AMDHome/Mechanical-Speedometer-Converter/assets/Schematics/OrCad/Symbol/Arduino Schmatic/Link.txt

https://www.snapeda.com/parts/A000005/Arduino/view-part/
