AMDHome/Mechanical-Speedometer-Converter/assets/High Level Diagram/Diagram.png

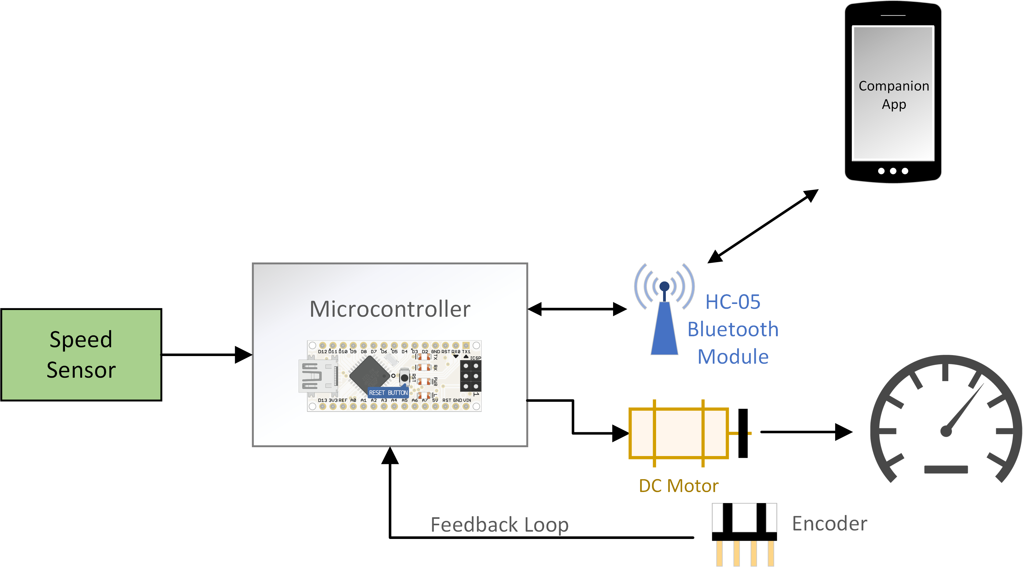
assets/High Level Diagram/Diagram.png
