AMDHome/Mechanical-Speedometer-Converter/assets/High Level Diagram/DiagramW.png

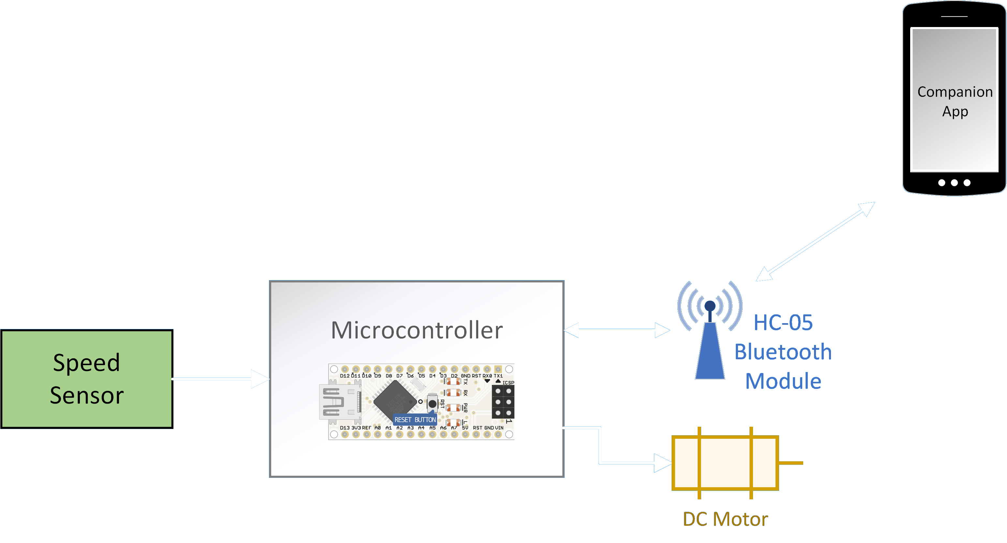
assets/High Level Diagram/DiagramW.png
