AMDHome/Mechanical-Speedometer-Converter/assets/Mockups/Device Select/Mockup Select Device.png

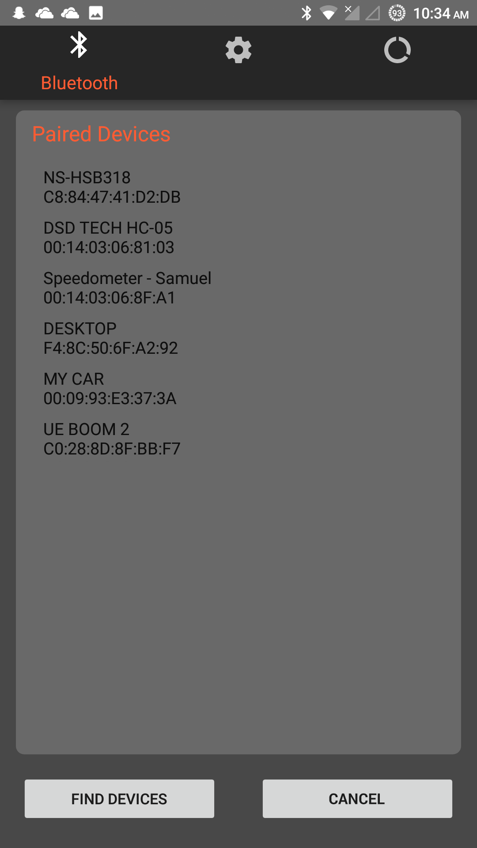
assets/Mockups/Device Select/Mockup Select Device.png
