AMDHome/Mechanical-Speedometer-Converter/assets/Mockups/Final Drive Wizard/PNG/Page10.png

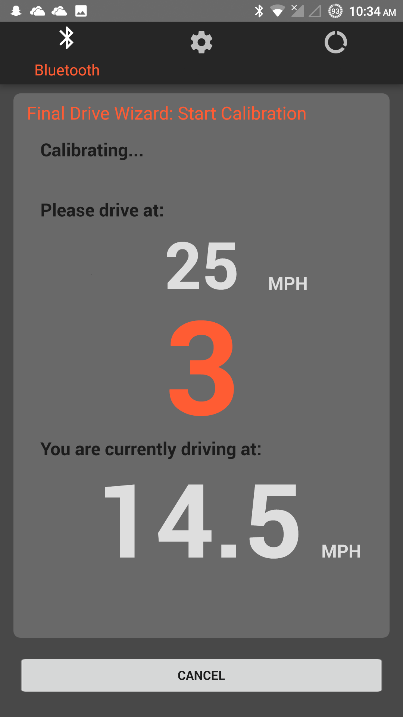
assets/Mockups/Final Drive Wizard/PNG/Page10.png
