AMDHome/Mechanical-Speedometer-Converter/assets/Mockups/Final Drive Wizard/PNG/Page 1.png

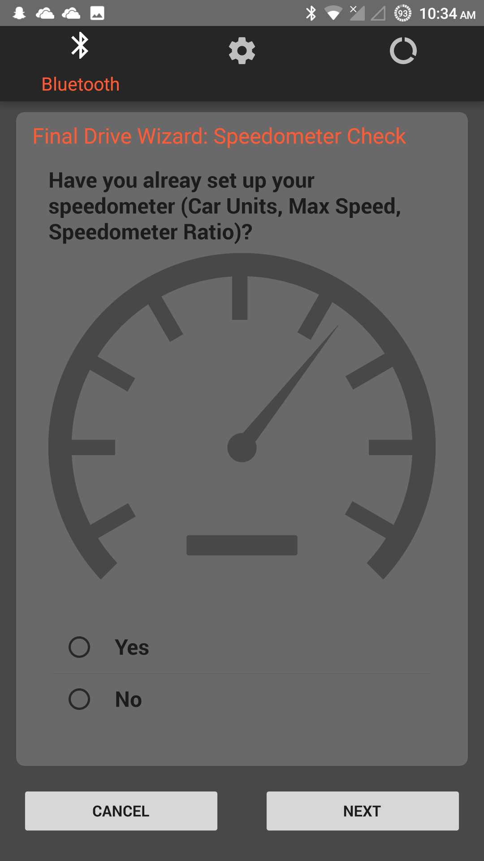
assets/Mockups/Final Drive Wizard/PNG/Page 1.png
