AMDHome/Mechanical-Speedometer-Converter/assets/Mockups/Final Drive Wizard/PNG/Page 2.png

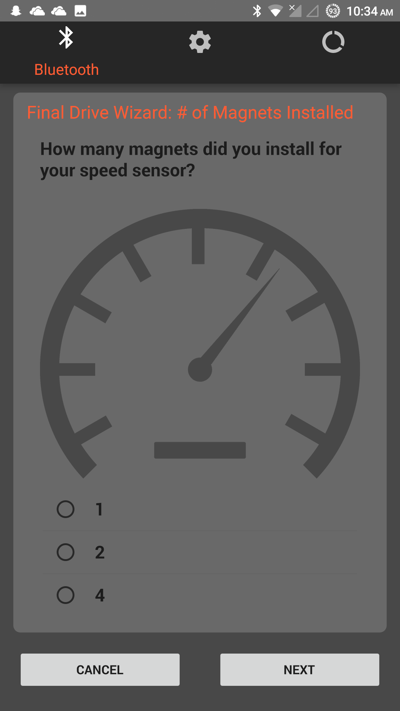
assets/Mockups/Final Drive Wizard/PNG/Page 2.png
