AMDHome/Mechanical-Speedometer-Converter/assets/Mockups/Final Drive Wizard/PNG/Page 3.png

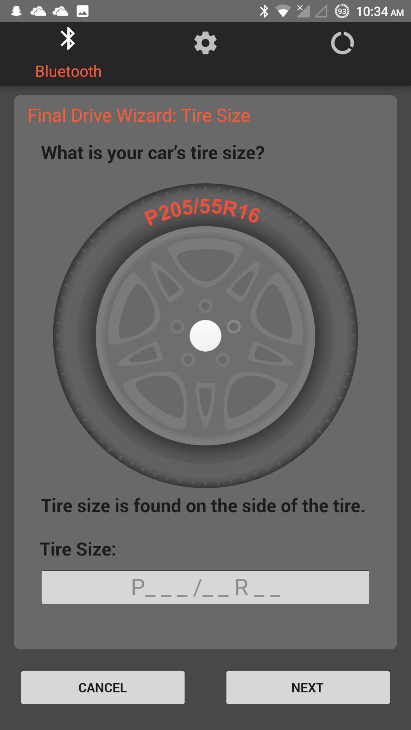
assets/Mockups/Final Drive Wizard/PNG/Page 3.png
