AMDHome/Mechanical-Speedometer-Converter/assets/Mockups/Final Drive Wizard/PNG/Page 4.png

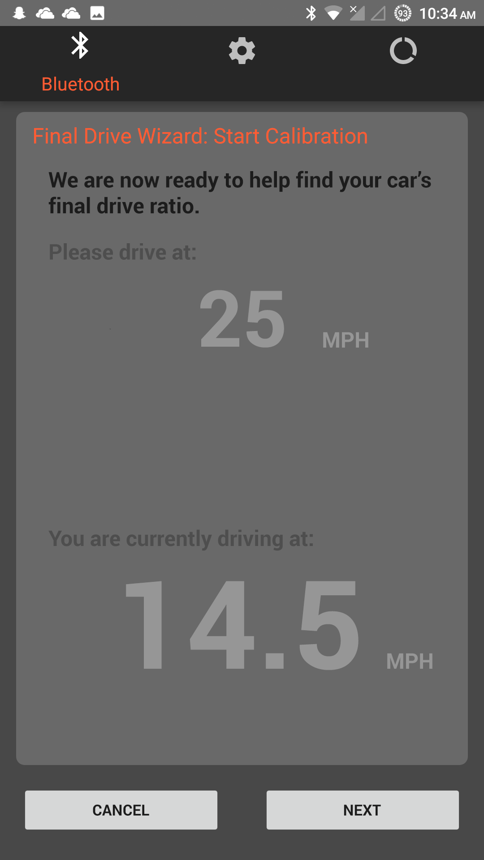
assets/Mockups/Final Drive Wizard/PNG/Page 4.png
