AMDHome/Mechanical-Speedometer-Converter/assets/Mockups/Final Drive Wizard/PNG/Page 5.png

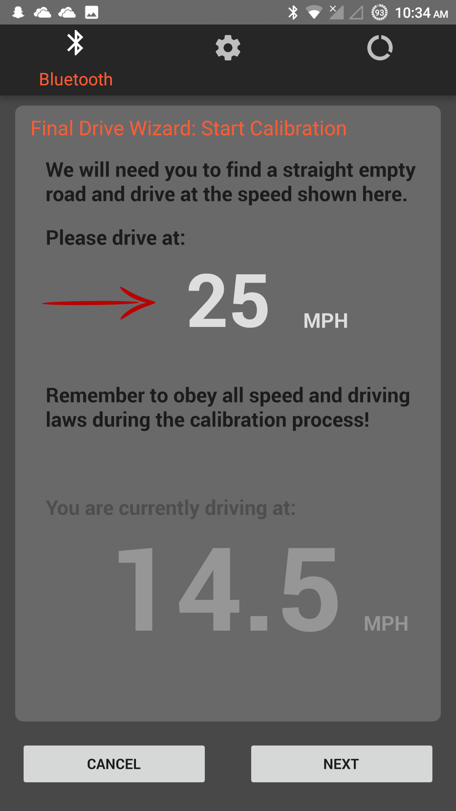
assets/Mockups/Final Drive Wizard/PNG/Page 5.png
