AMDHome/Mechanical-Speedometer-Converter/assets/Mockups/Final Drive Wizard/PNG/Page 6.png

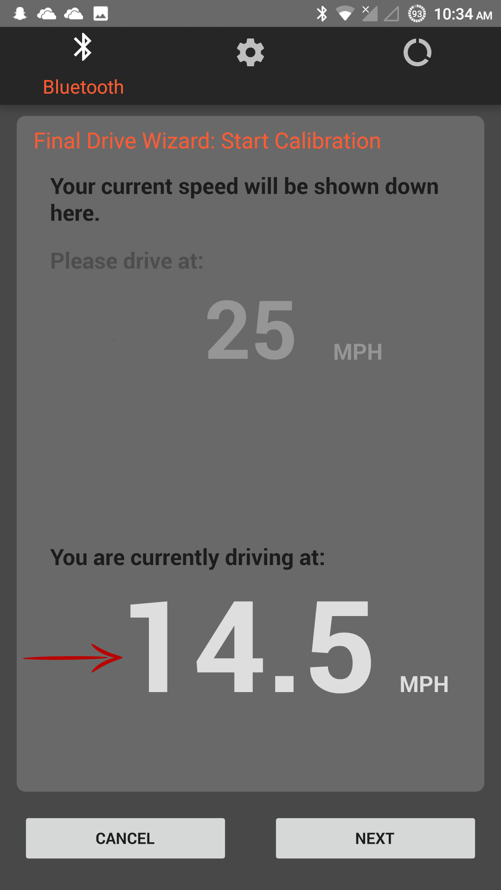
assets/Mockups/Final Drive Wizard/PNG/Page 6.png
