AMDHome/Mechanical-Speedometer-Converter/assets/Mockups/Final Drive Wizard/PNG/Page 7.png

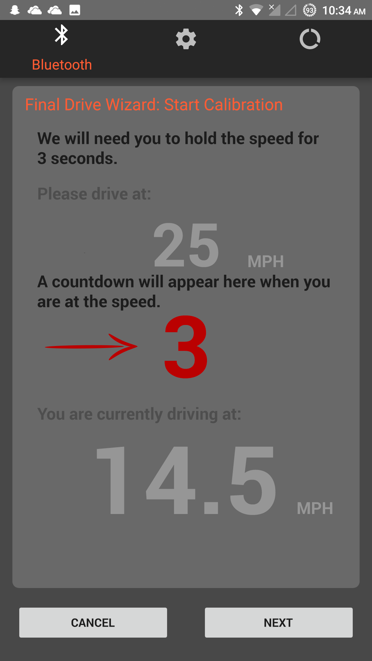
assets/Mockups/Final Drive Wizard/PNG/Page 7.png
