AMDHome/Mechanical-Speedometer-Converter/assets/Mockups/Final Drive Wizard/PNG/Page 8.png

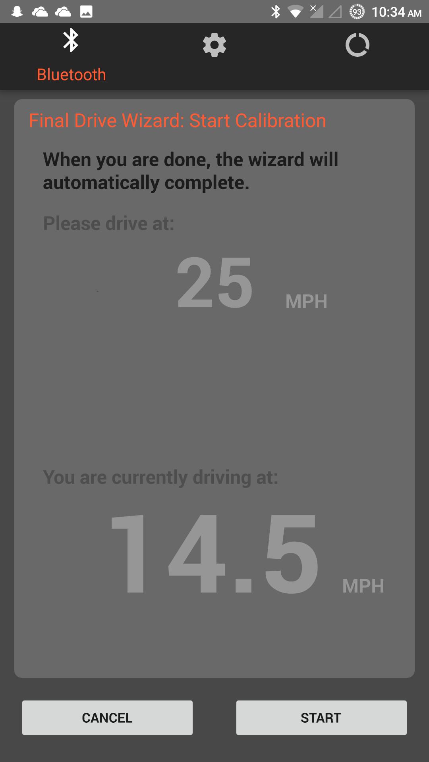
assets/Mockups/Final Drive Wizard/PNG/Page 8.png
