AMDHome/Mechanical-Speedometer-Converter/assets/Mockups/Final Drive Wizard/PNG/Page 9.png

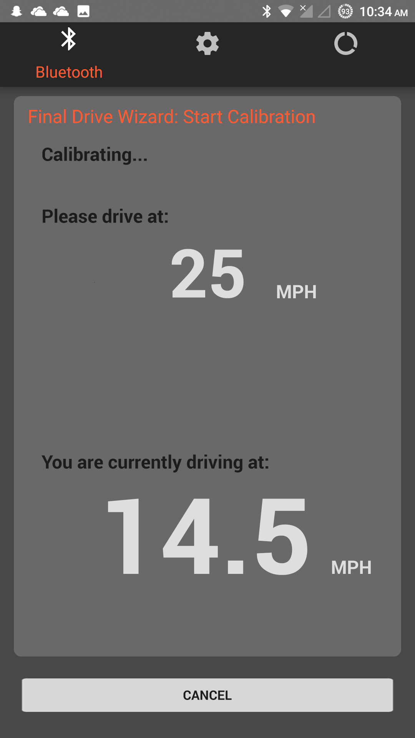
assets/Mockups/Final Drive Wizard/PNG/Page 9.png
