AMDHome/Mechanical-Speedometer-Converter/assets/Mockups/Main UI/Mockup New Settings.png

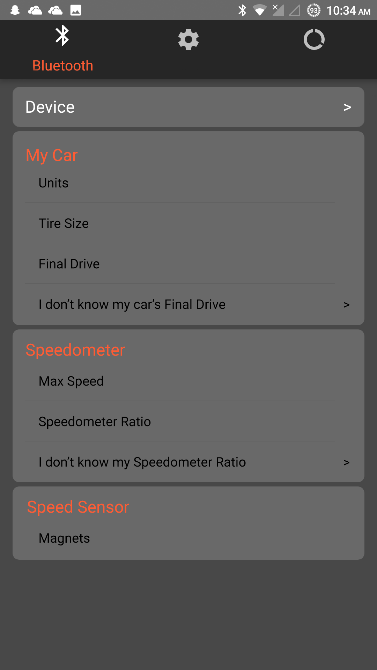
assets/Mockups/Main UI/Mockup New Settings.png
