AMDHome/Mechanical-Speedometer-Converter/assets/Mockups/Main UI/Mockup Settings Filled.png

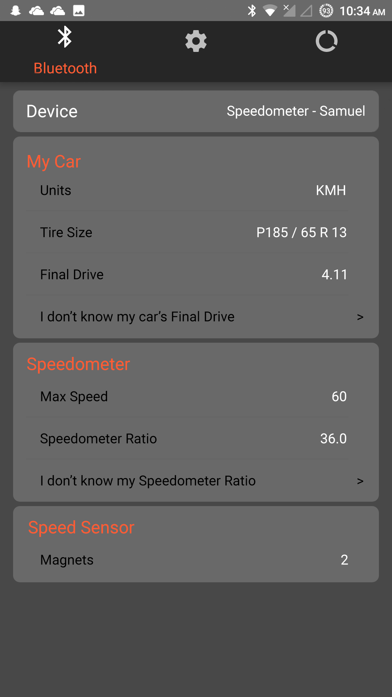
assets/Mockups/Main UI/Mockup Settings Filled.png
