AMDHome/Mechanical-Speedometer-Converter/assets/Mockups/Speedometer Wizard/speedo-1970476-custom.png

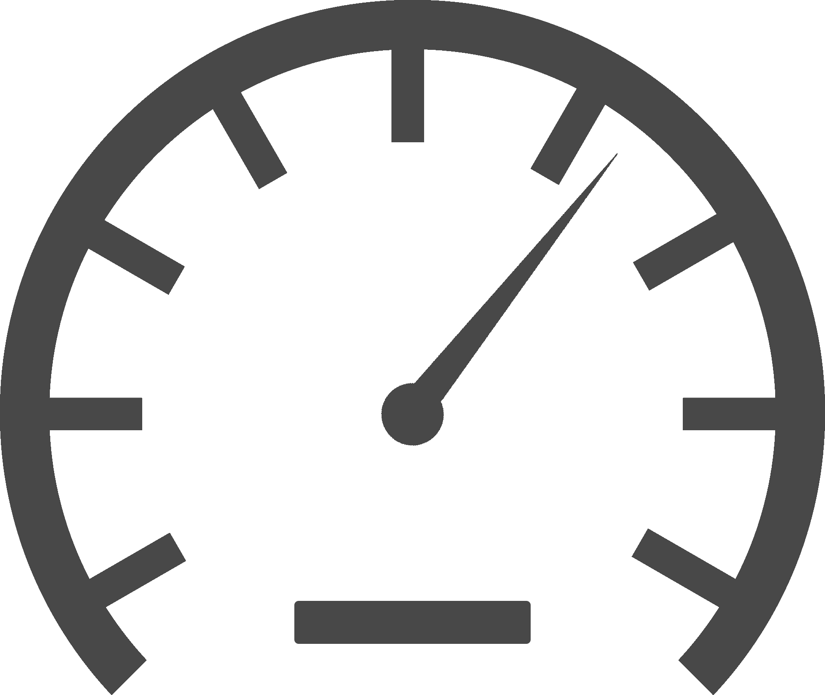
assets/Mockups/Speedometer Wizard/speedo-1970476-custom.png
