AMDHome/Mechanical-Speedometer-Converter/assets/Mockups/Speedometer Wizard/Speedometer Wizard_Max Speed.png

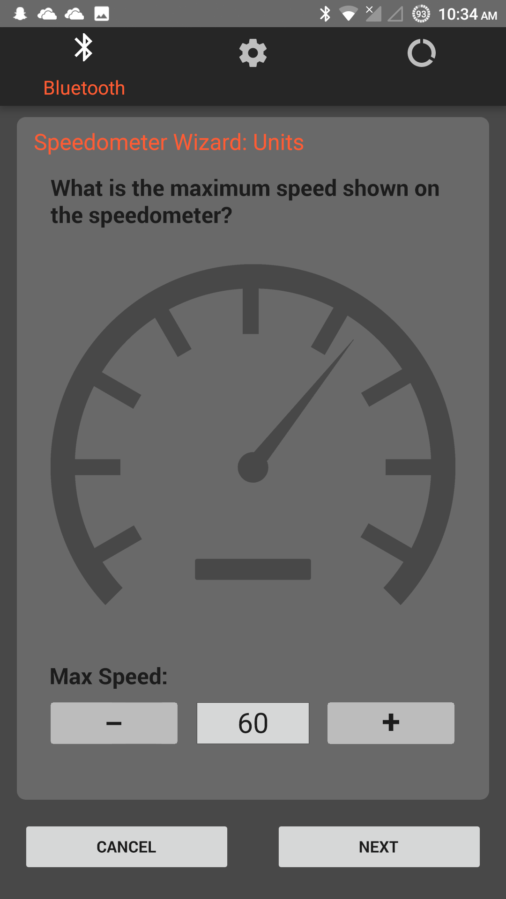
assets/Mockups/Speedometer Wizard/Speedometer Wizard_Max Speed.png
