AMDHome/Mechanical-Speedometer-Converter/assets/Mockups/Speedometer Wizard/Speedometer Wizard_SRatio.png

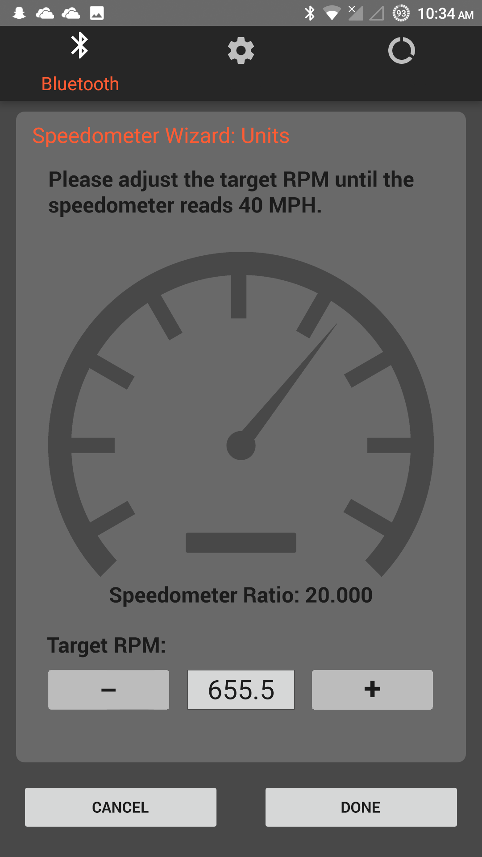
assets/Mockups/Speedometer Wizard/Speedometer Wizard_SRatio.png
