AMDHome/Mechanical-Speedometer-Converter/assets/Schematics/Protoboard.png

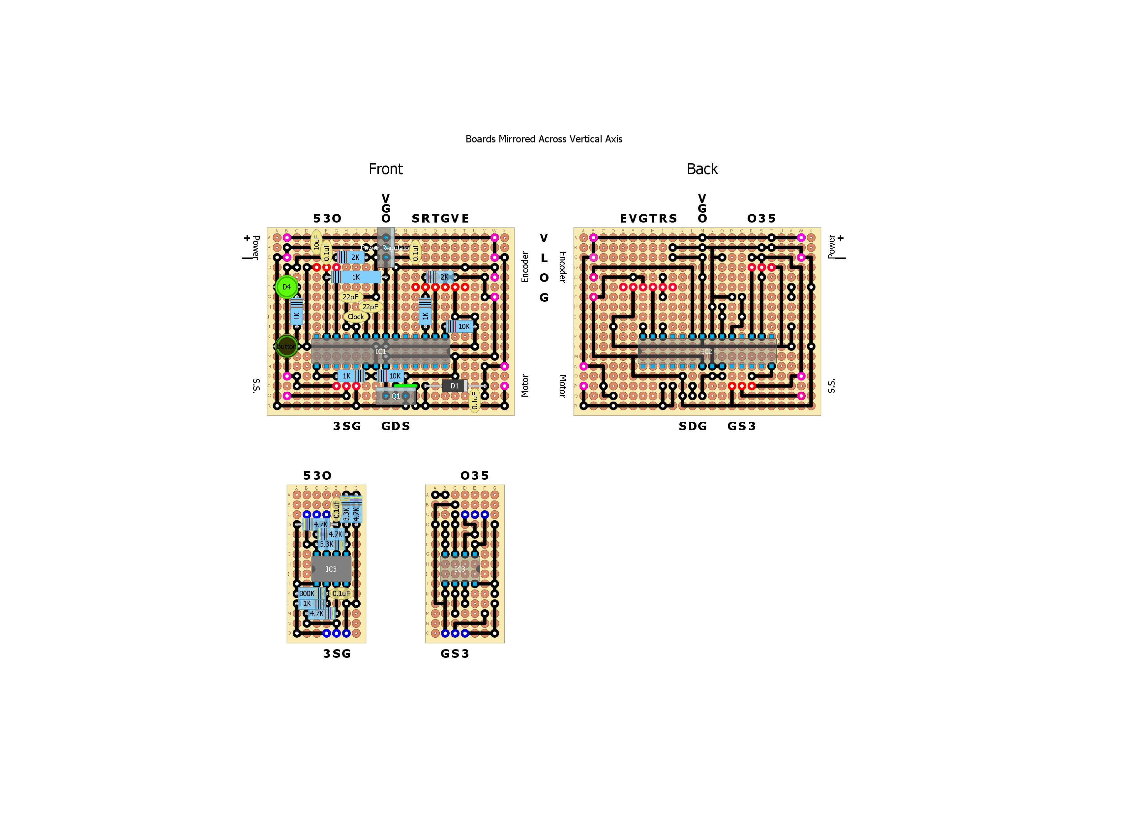
assets/Schematics/Protoboard.png
