AMDHome/Mechanical-Speedometer-Converter/assets/3D Printing/Motor Holder.3mf

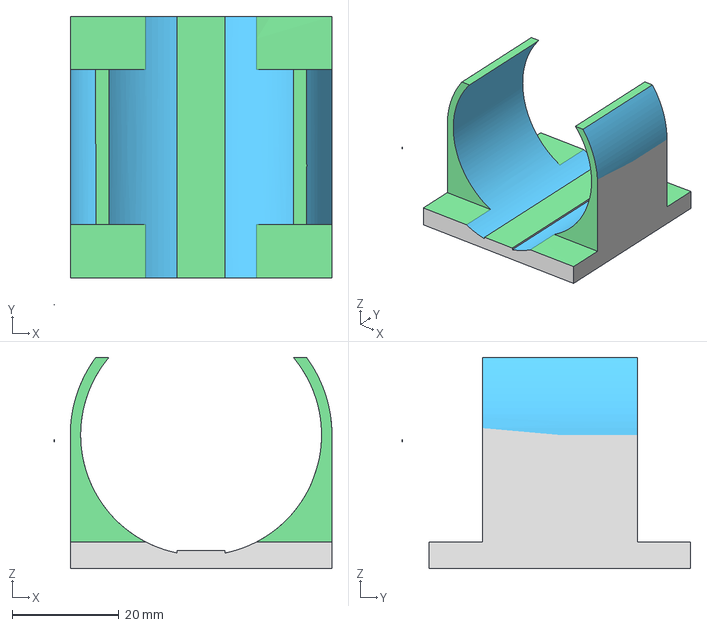
[picture p26: CAD file, 2019-02-13]
assets/3D Printing/Motor Holder.3mf
52.0 x 54.0 x 39.5 mm
