AMDHome/Mechanical-Speedometer-Converter/assets/3D Printing/5mm_Shaft_Couplerv2.stl

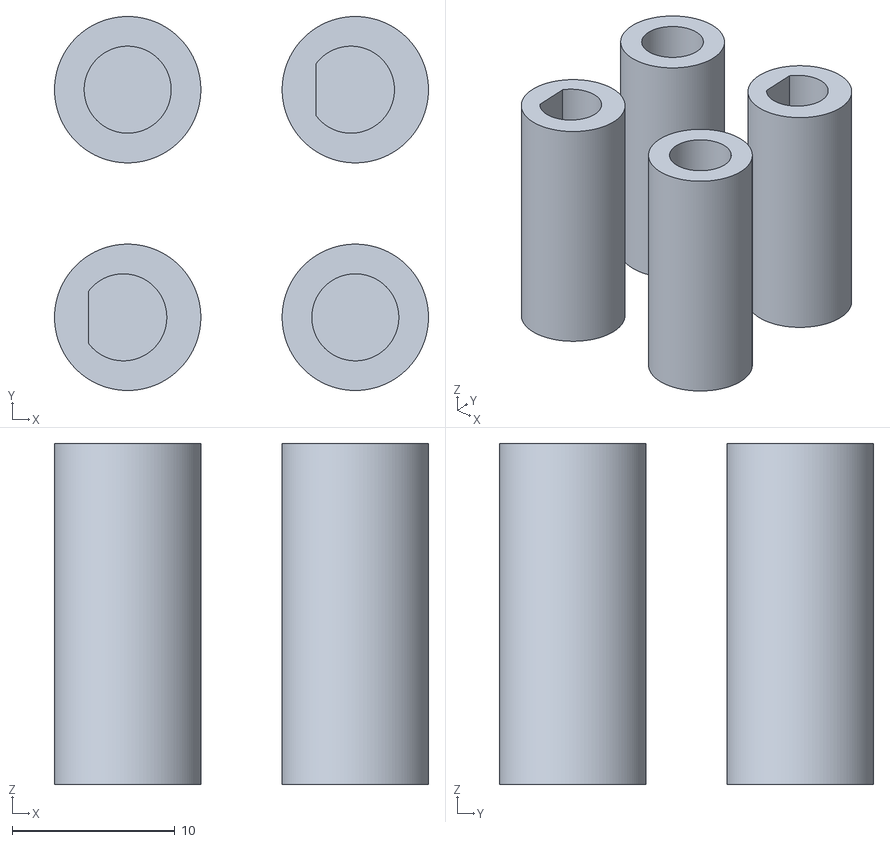
[picture p27: CAD file, 2019-02-13]
assets/3D Printing/5mm_Shaft_Couplerv2.stl
23.0 x 23.0 x 21.0
