AMDHome/Mechanical-Speedometer-Converter/assets/3D Printing/5mm_Shaft_Coupler.3mf

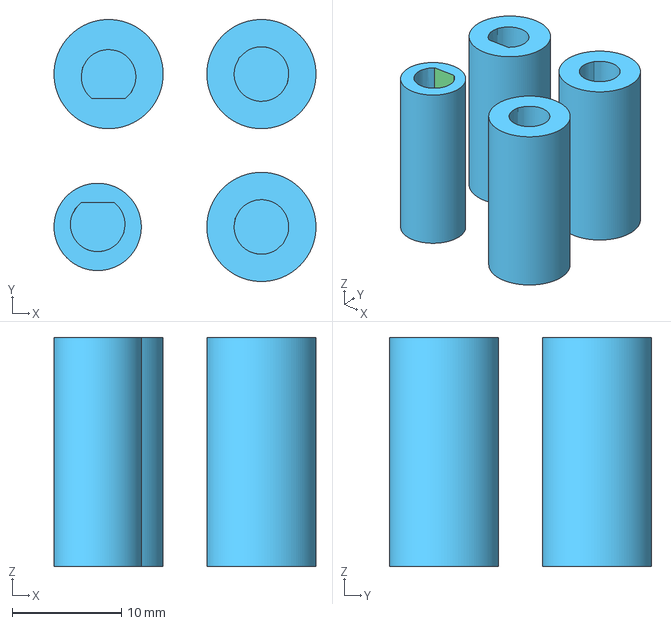
[picture p28: CAD file, 2019-02-13]
assets/3D Printing/5mm_Shaft_Coupler.3mf
24.0 x 24.0 x 21.0 mm
