AMDHome/Mechanical-Speedometer-Converter/(list of files, cad)

Other CAD files:
assets/3D Printing/5mm_Shaft_Coupler.stl
assets/3D Printing/Motor Holder.stl
assets/Schematics/OrCad/Symbol/ATMEGA328P/dip254p762x457-28.psm
assets/Schematics/OrCad/Symbol/Arduino Schmatic/arduino_a000005.psm
assets/Schematics/OrCad/Symbol/Button/434113025826.psm
assets/Schematics/OrCad/Symbol/Diode/do41-1.psm
assets/Schematics/OrCad/Symbol/Diode/do41-2.psm
assets/Schematics/OrCad/Symbol/Diode/do41-3.psm
assets/Schematics/OrCad/Symbol/Diode/do41-4.psm
assets/Schematics/OrCad/Symbol/L7805CV/to254p460x1020x1945-3p.psm
assets/Schematics/OrCad/Symbol/LED/led-3mm-round.psm
assets/Schematics/OrCad/Symbol/LED/led-5mm-round.psm
assets/Schematics/OrCad/Symbol/xtal/xtal1140x490x430n.psm
