AMDHome/Mechanical-Speedometer-Converter/assets/Schematics/Schematics.pdf

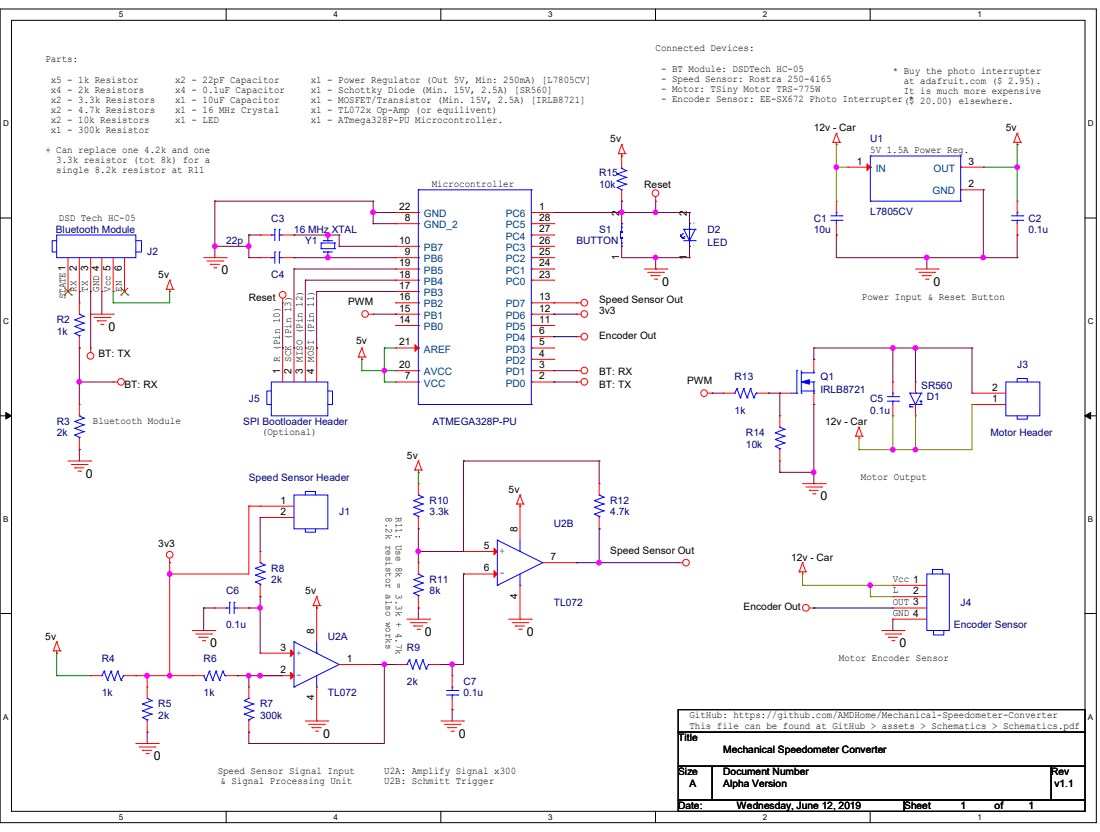
[picture p35: page 1]

Connected Devices:
- BT Module: DSDTech HC-05
- Speed Sensor: Rostra 250-4165
- Motor: TSiny Motor TRS-775W

Parts:
x5 - 1k Resistor
x4 - 2k Resistors
x2 - 3.3k Resistors
($ 20.00) elsewhere. RX TX GND Vcc
x2 - 4.7k Resistors
x2 - 10k Resistors
x1 - 300k Resistor
+ Can replace one 4.2k and one
3.3k resistor (tot 8k) for a
single 8.2k resistor at R11 STATE

x1 - Power Regulator (Out 5V, Min: 250mA) [L7805CV]
x1 - Schottky Diode (Min. 15V, 2.5A) [SR560]
x1 - MOSFET/Transistor (Min. 15V, 2.5A) [IRLB8721]
x1 - TL072x Op-Amp (or equilivent)
x1 - ATmega328P-PU Microcontroller.

* Buy the photo interrupter
at adafruit.com ($ 2.95).
It is much more expensive

- Encoder Sensor: EE-SX672 Photo Interrupter * EN

5V 1.5A Power Reg. 8.2k resistor also works R11: Use 8k = 3.3k + 4.7k

U2B: Schmitt Trigger R (Pin 10) SCK (Pin 13) MISO (Pin 12) MOSI (Pin 11)

Power Input & Reset Button

Speed Sensor Signal Input
& Signal Processing Unit
