AMDHome/Mechanical-Speedometer-Converter/(list of files, drawings)

Other design files:
assets/Schematics/OrCad/MECHANICAL SPEEDOMETER CONVERTER.DSN
assets/Schematics/OrCad/Mechanical Speedometer Converter.opj
assets/Schematics/OrCad/Symbol/Arduino Schmatic/A000005.OLB
assets/Schematics/OrCad/Symbol/ATMEGA328P/ATMEGA328P-PU.OLB
assets/Schematics/OrCad/Symbol/Button/434113025826.OLB
assets/Schematics/OrCad/Symbol/Diode/1N5817.OLB
assets/Schematics/OrCad/Symbol/L7805CV/L7805CV.OLB
assets/Schematics/OrCad/Symbol/LED/WL-TMRC.OLB
assets/Schematics/OrCad/Symbol/xtal/LFXTAL003237.OLB
