AMDHome/Mechanical-Speedometer-Converter/(commit log)

2019-02-04 Added Stepper Driver Library
2019-02-04 Added Test Program (Hopefully can test motors)
2019-02-12 Basic PWM via Timer Implemented. (Change OCR1A)
2019-02-12 Complete Motor Control Implemented
2019-02-13 Added Assets folder for 3d Modeling and schematics
    [5mm_Shaft_Coupler.3mf, 5mm_Shaft_Coupler.stl, 5mm_Shaft_Couplerv2.stl, Motor Holder.3mf, Motor Holder.stl]
2019-02-13 Finished Schematic
2019-02-27 Initial SerialMonitor
    New android studio project yet to be merged/integrated with master
    Ability to search and connect to HC05 (change/connecivity-status is indicated by blinking on HC05)
    Buttons on next screen send 'a' and 'd' to arduino while 'disconnect' disconnects the bluetooth and returns to last screen
2019-02-27 Updated Assets
    [BMW speedo calcs.xls]
2019-02-27 added speed sensor code into code. (needs testing)
2019-02-27 Pushed wrong code, Reverting changes
    [controller.ino]
2019-03-06 Speed sensor tested and working (hopefully math is correct)
    [controller.ino]
2019-03-07 Simplified some calculations and stops motor when 0mph
2019-03-07 pid algorithm rough draft
2019-03-07 added file from master
    [BMW speedo calcs.xls]
2019-03-08 PID Complete, needs testing
2019-03-11 Added wiring2.cpp/h and controller changes
2019-03-11 Updated pid with feed foward, wrapped in the new Timer0-based ISR
2019-03-12 Enable External Clock Interrupts
2019-03-12 added on off buttons from brians code
2019-03-12 Added PULLUP to pin 4
2019-03-13 Wrote test for pid
2019-03-13 added wheel circumference and wheel size calculation
2019-03-14 Moved speed sensor calc into main loop
2019-03-31 Preliminary arduino code. Needs extensive testing
2019-03-31 Updated Assets in Main
    * Updated Schematic Drawing
    * Added Alpha Schematics as well as OrCad files that produced it
    [1N5817.OLB, A000005.OLB, EDI2CAP.CFG, MECHANICAL SPEEDOMETER CONVERTER.DSN, Mechanical Speedometer Converter.opj, arduino_a000005.psm, do41-1.psm, do41-2.psm]
2019-03-31 Minor updates to schematics
    [MECHANICAL SPEEDOMETER CONVERTER.DSN, Mechanical Speedometer Converter.opj]
2019-04-03 Refactored the way we count current RPM. Updated PID
2019-04-03 Tested and fixed U:
    U: was sending strings instead of values 0 and 1.
    Unsure if code will send to arduino in compatiable format. Should send like POC implementation. Unsure of proper use of Wheel size and wheel circumference.
2019-04-03 Added Github URL to Schematics.pdf
    [MECHANICAL SPEEDOMETER CONVERTER.DSN, Mechanical Speedometer Converter.opj]
2019-04-05 Update Schematic's URL
    [MECHANICAL SPEEDOMETER CONVERTER.DSN, Mechanical Speedometer Converter.opj]
2019-04-05 Fixed an incorrect voltage source
    [MECHANICAL SPEEDOMETER CONVERTER.DSN]
2019-04-08 Reapplying stashed changes
    [Mechanical Speedometer Converter.opj]
2019-04-09 Updated Diagrams
    [MECHANICAL SPEEDOMETER CONVERTER.DSN]
2019-04-13 Fix Voltage in schematics
    [MECHANICAL SPEEDOMETER CONVERTER.DSN]
2019-04-13 Updated code to reduce strain on power delivery system
2019-04-24 added bluetooth device name after selection
2019-04-27 Redo schematics to mirror current changes
    [434113025826.OLB, 434113025826.psm, ATMEGA328P-PU.OLB, EDI2CAP.CFG, L7805CV.OLB, LFXTAL003237.OLB, MECHANICAL SPEEDOMETER CONVERTER.DSN, Mechanical Speedometer Converter.opj]
2019-05-01 added all functionalities for meter ratio calibration wizard UI
2019-05-08 added gps functionalized for wizard calibration
2019-05-08 added restrictions to tiresize input in wizard
2019-05-10 Changed behavior of current rpm for debugging purposes
2019-05-10 Increased pwm frequency
2019-05-11 fixed tire size input to/from arduino
2019-05-15 Refactored most of the arduino code to run more smoothly.
2019-05-16 added code to get values from arduino
2019-05-21 added more user friendly functionalities. testing tiresize box rn
2019-05-21 allow automatical keyboard pop ups and complete data with keyboard enter button
2019-05-27 changed final drive arduino command
2019-05-29 changed text color in bt list and arduino command
2019-05-29 changed background color for alert dialog, fixed problem for bt device name
2019-06-05 RC2: PID Needs a bit more tuning. Drill keeps dying
2019-06-10 Updated Some Documentation
    [MECHANICAL SPEEDOMETER CONVERTER.DSN, Mechanical Speedometer Converter.opj]
2019-06-13 Update assets
    [MECHANICAL SPEEDOMETER CONVERTER.DSN, Mechanical Speedometer Converter.opj]
2019-06-13 Fixed an Incorrect Equation
    [BTComms.cpp]
